Mgzz03/VMO-Robot_Embedded_Systems/(list of files, drawings)

Other design files:
3_Hardware_and_Simulation/VMO_Proteus_Simulation.pdsprj
